reijndert/ardufoon/Ardufoon_schematic_4feb2020.jpg

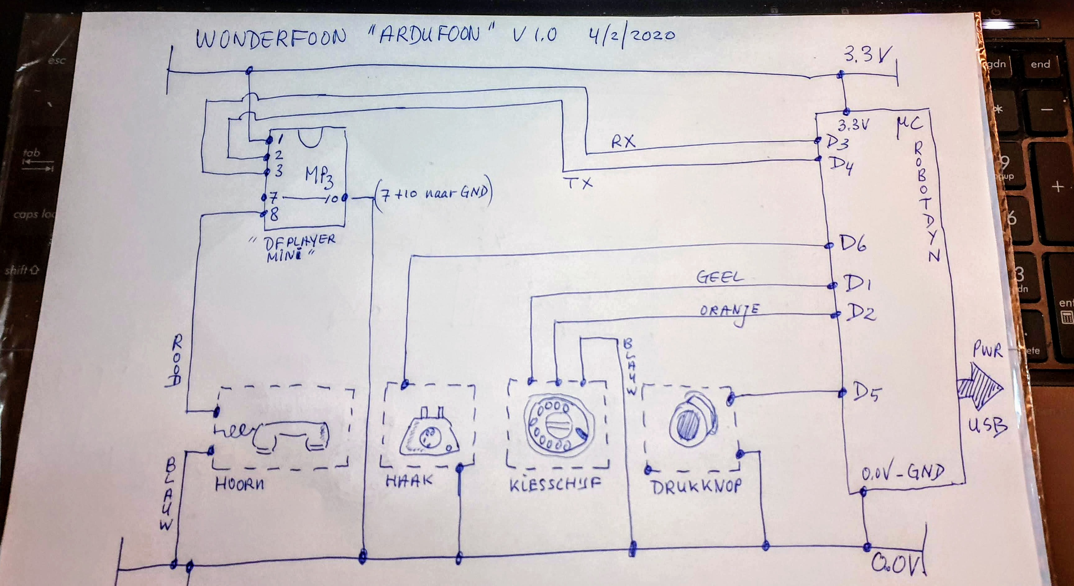
Ardufoon_schematic_4feb2020.jpg
