reijndert/ardufoon/EasyEDA/PCB.jpg

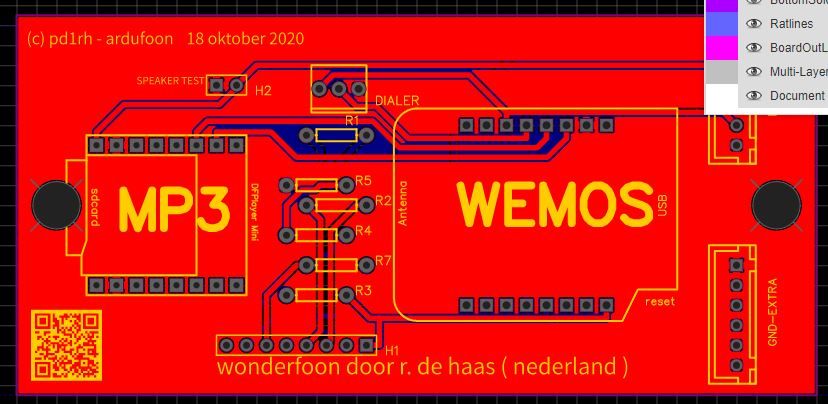
EasyEDA/PCB.jpg
