reijndert/ardufoon/README.md

# ardufoon
A musicbox for your old Dutch telephone

* Folder names from 01 to 10
* Easy LOCK   to a specific folder (so limits to 10 songs).
* Easy UNLOCK
* Don't forget the folder '99' !
* Change volume with pushbutton 
* Play random song using pushbotton
* Play a song by dialing a number 0 - 9  or 01 - 99
* Diagnostic LED when available
* Some old dutch service numbers are working :-)

Have fun !
