reijndert/ardufoon/T65-kiesschijf-toestel-tekening-1024x733.jpg

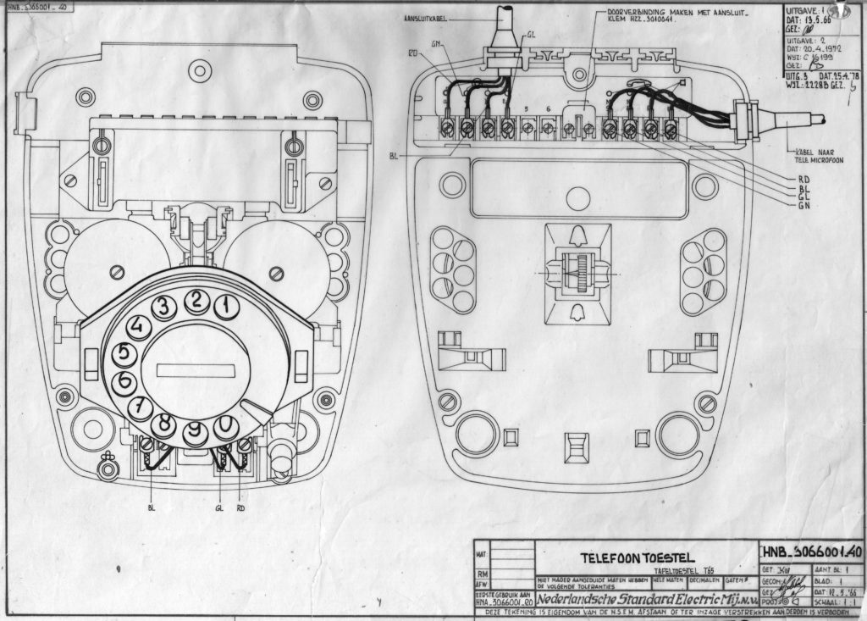
T65-kiesschijf-toestel-tekening-1024x733.jpg
