reijndert/ardufoon/T65-TDK-toestel-schema-1024x713.jpg

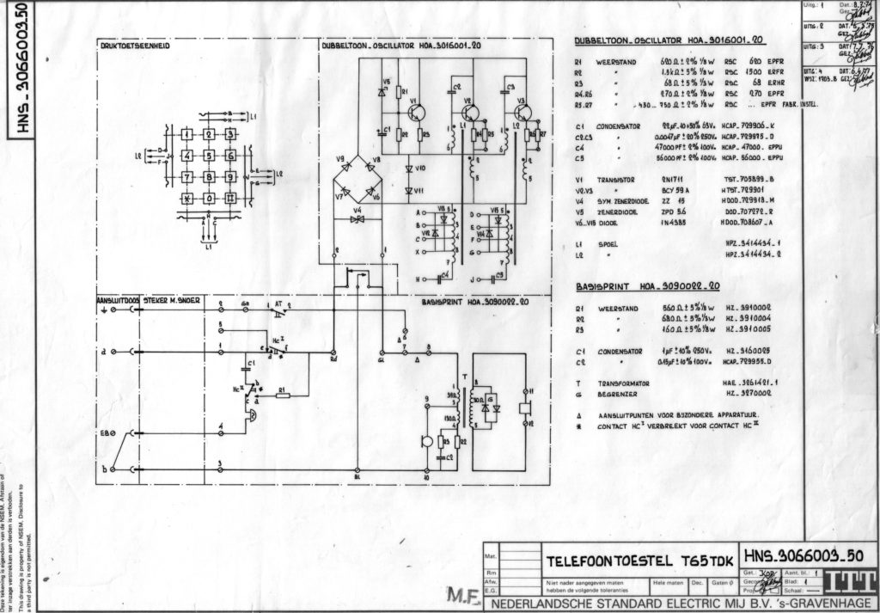
T65-TDK-toestel-schema-1024x713.jpg
