reijndert/ardufoon/(list of files, drawings)

Other design files:
EasyEDA/Ardufoon 1.9 - WEMOS_2020-08-29_13-25-48.json
EasyEDA/PCB_2020-08-29_13-24-42.json
