reijndert/ardufoon/Korte instructie.docx

Wonderfoon “Ardufoon” v1.6 van PD1RH
(Ontworpen door Reijndert de Haas, pd1rh, uit Assen)

Zet de telefoon aan door deze via een USB lader op het stopcontact of rechtstreeks op een USB Power Bank aan te sluiten.

Neem na een paar seconden de hoorn van de haak, u hoort nu een kiestoon. Met de witte drukknop kunt u het volume regelen. Draai één cijfer en u hoort het bijbehorende liedje uit een set van tien liedjes.

U kunt een nieuwe set van tien liedjes kiezen door kort na elkaar twee cijfers te draaien. Het eerste cijfer is dan het nummer van de set, het tweede nummer het liedje binnen de set.

Voorbeeld (op volgorde):
(aanname: er bestaan 5 sets van 10 liedjes)

[1]-[1] Speel liedje 1 van set 1 (de set wordt onthouden)

[3] Speel liedje 3 uit set 1

[7] Speel liedje 7 uit set 1

[5]-[4] Speel liedje 4 uit set 5

[9] Speel liedje 9 uit set 5

[4]-[2] Speel liedje 2 uit set 4.

Als een set wordt gekozen die niet bestaat (bijv. ‘7’ in dit voorbeeld) wordt teruggesprongen naar set 1. Er speelt dus altijd een liedje.

Onder nummer [0]-[0]-[2] is een nep-tijdmelding opgeslagen.
Met de echte stem van vroeger.

Het is mogelijk om de telefoon “vast te zetten” op één map/set. Er kan dan niet meer ‘zomaar’ gewisseld worden. Dit gaat als volgt voor bijv map/set 3:
Kies 3, draai tot de aanslag, houdt de witte knop ingedrukt en laat de 3 weer los.
Deze stand wordt onthouden ook als de telefoon spanningsloos is.
Om deze stand op te heffen, kies [9]-[9]-[9]. Ter bevestiging volgt een kiestoon.

Veel plezier met deze ‘Ardufoon’ Wonderfoon!
